PawelZieba01/PV_DC_driver/simulations/PWM_NMOS_driver/pwm_nmos_driver.asc

D1: schottky; 1N5817
M1: nmos; SUM85N03-06P
Q1: npn; 2N2222
Q2: pnp; 2N2907
Q3: npn2; 2SC4725
Q4: npn2; 2SC4725
R1: res; 17.63
R2: res; 470
R3: res; 2k
R4: res; 20
R5: res; 4.7k
R6: res; 10k
R7: res; 10k
V1: voltage; 250
V2: voltage; PULSE(0 3.3 0 1p 1p 10u 100u)
V3: voltage; 12
Named nets: 0
;.dc V1 0 250 1
.tran 0 10m 9m 0.1m
HEATER
PV SOURCE
12V DC POWER SUPPY
PWM SOURCE
