PawelZieba01/PV_DC_driver/tools/ESP32_ADC_calibration_tool/images/ADC_sheet_step_3.png

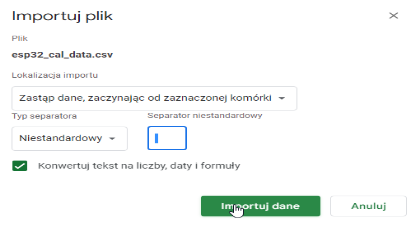
tools/ESP32_ADC_calibration_tool/images/ADC_sheet_step_3.png
