PawelZieba01/PV_DC_driver/docs/current_measurement_layout.png

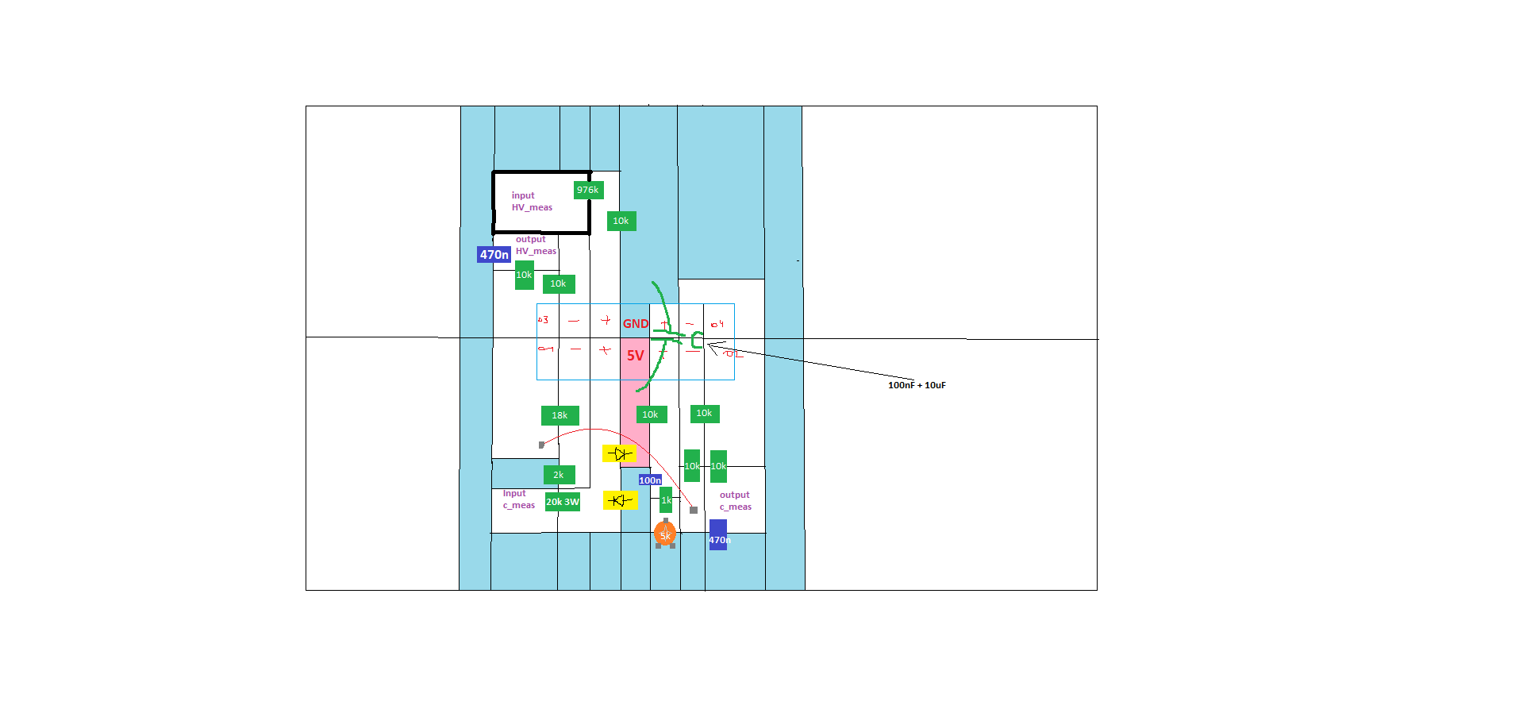
docs/current_measurement_layout.png
