PawelZieba01/PV_DC_driver/images/Current_measurement_PD.png

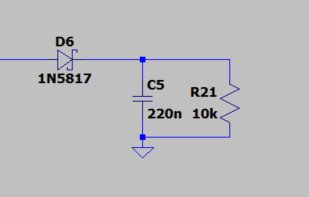
images/Current_measurement_PD.png
