PawelZieba01/PV_DC_driver/tools/ESP32_ADC_calibration_tool/images/ESP32_ADC_measuring_circuit.png

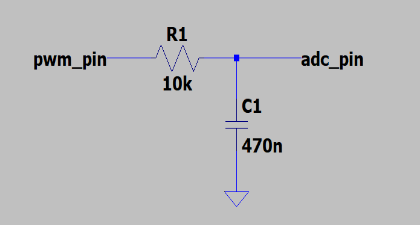
tools/ESP32_ADC_calibration_tool/images/ESP32_ADC_measuring_circuit.png
