PawelZieba01/PV_DC_driver/(commit log)

2022-06-17 Add PWM_MPPT simulation
2022-07-07 Add RC filter and operational amplifier to MPPT simulation
2022-08-02 Update README.md, simulations and images
    [adc_esp32.xlsx]
2022-08-09 Add ADC calibration manual
2022-08-13 Update README.md and PWM_MPPT_simulation
2022-08-29 Update pwm_nmos_driver simulation
2022-09-20 Update README.md and pwm_nmos_driver simulation
2022-09-28 Update simulations PWM_MPPT and pwm_nmos_driver
2023-02-22 esp32 pinout image
2023-02-22 Add esp32 pinout iformations
2023-02-22 Resize and rename esp32_pinout image
2023-02-22 Fix ESP32_pinout image
2023-04-24 Add current_measurement_layout for test board
